rago27/XLR8/README.md

# XLR8
Contains the experiences, learnings, innovations and pictures of XLR8, by Team Osiris. Here's our bot:
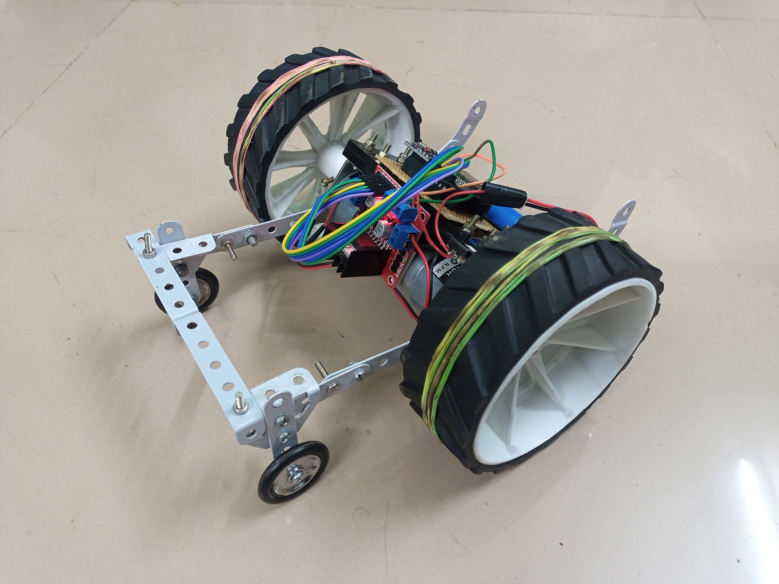
[picture p1: pics/v2_rear.jpeg]
Our Bot
