rago27/XLR8/pics/firstboard.jpg

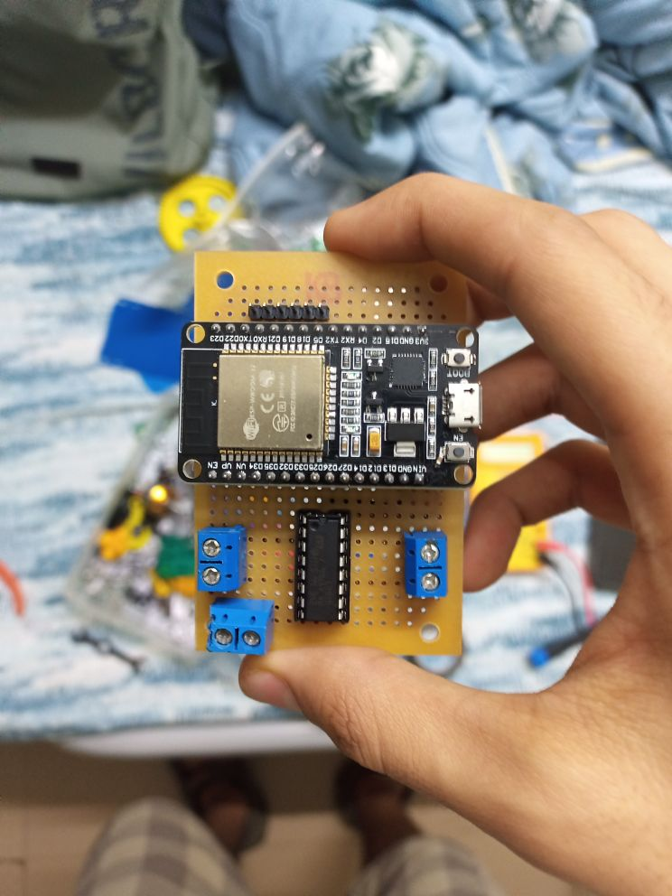
pics/firstboard.jpg
