rago27/XLR8/pics/inside_johnson.jpg

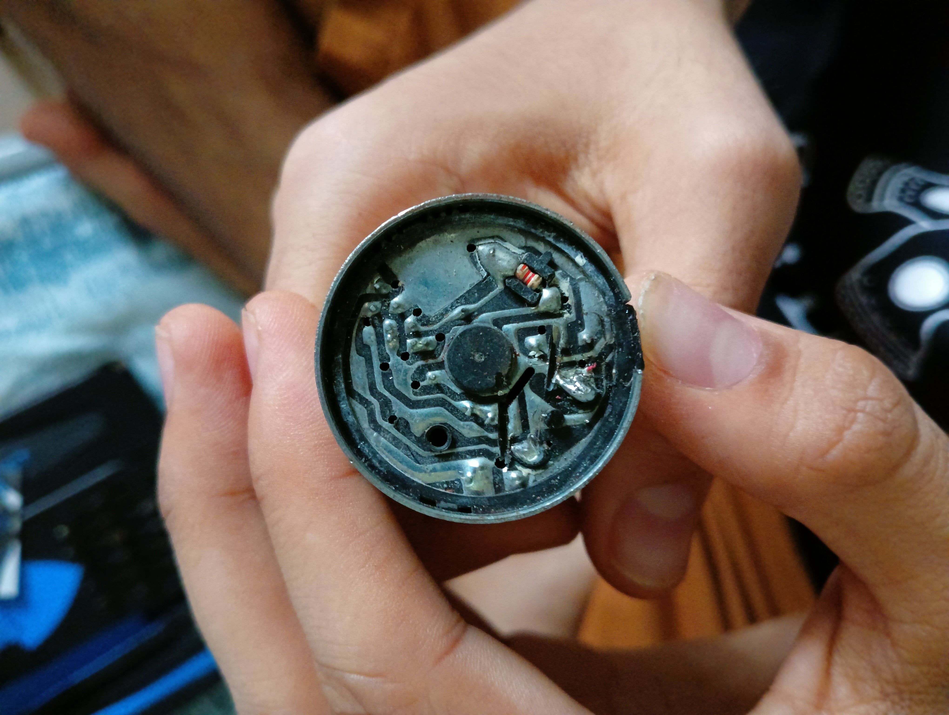
pics/inside_johnson.jpg
