rago27/XLR8/pics/v1.5_bottom.jpeg

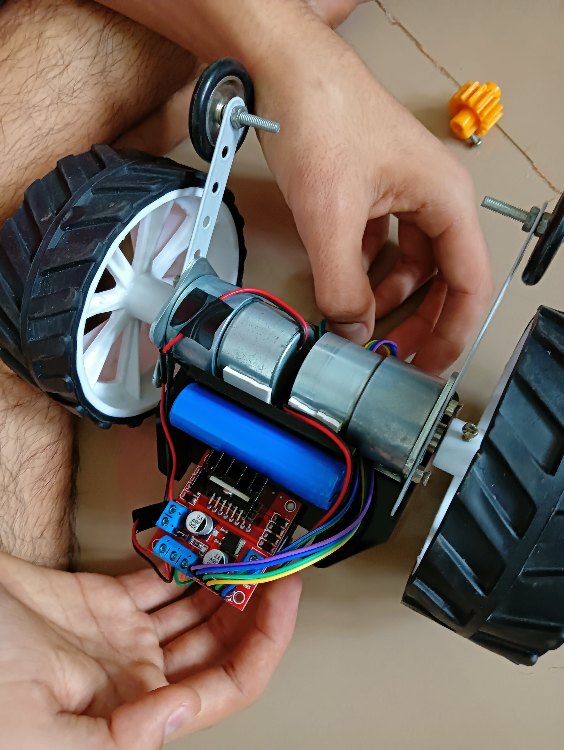
pics/v1.5_bottom.jpeg
