rago27/XLR8/pics/v1_FV.jpeg

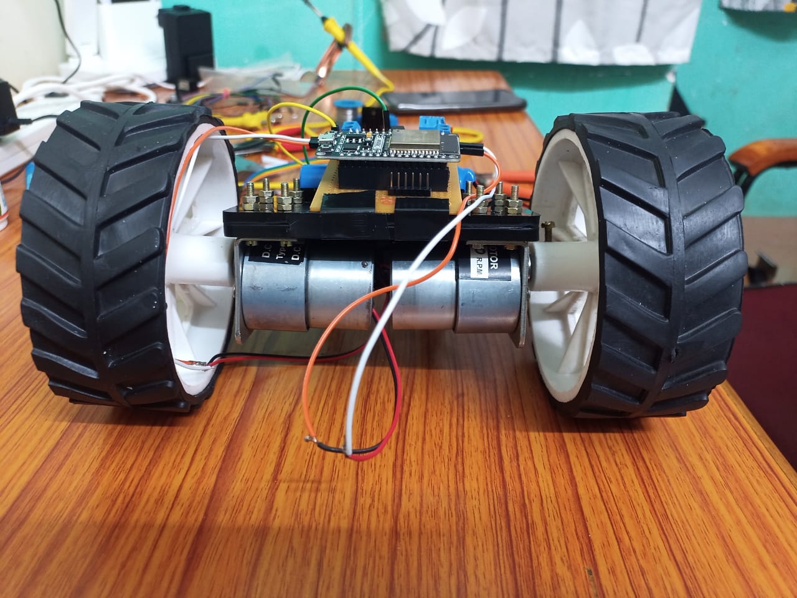
pics/v1_FV.jpeg
