rago27/XLR8/pics/v1_iso.jpeg

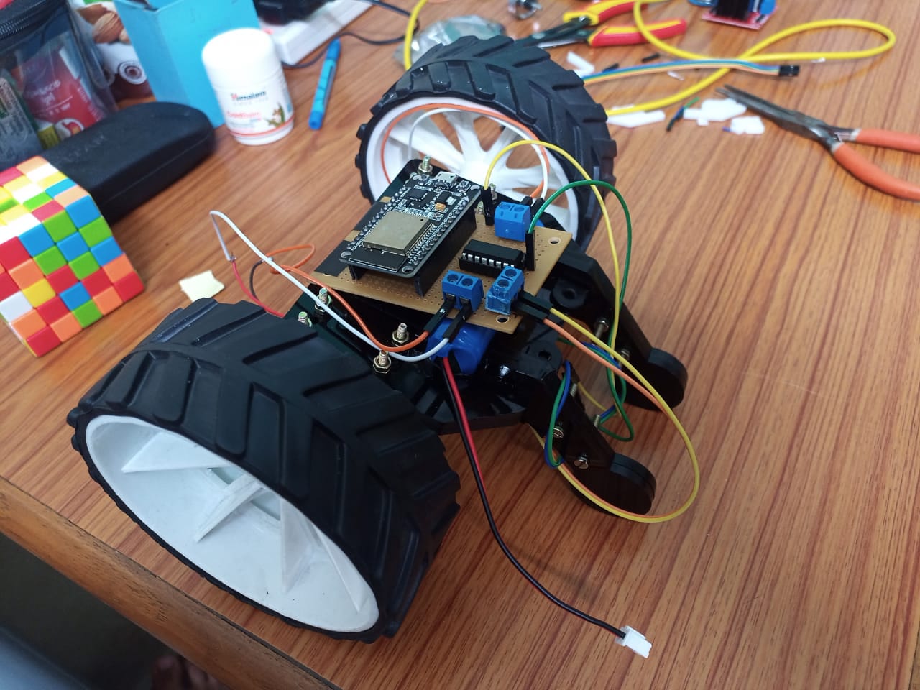
pics/v1_iso.jpeg
