rago27/XLR8/pics/v1_TV.jpeg

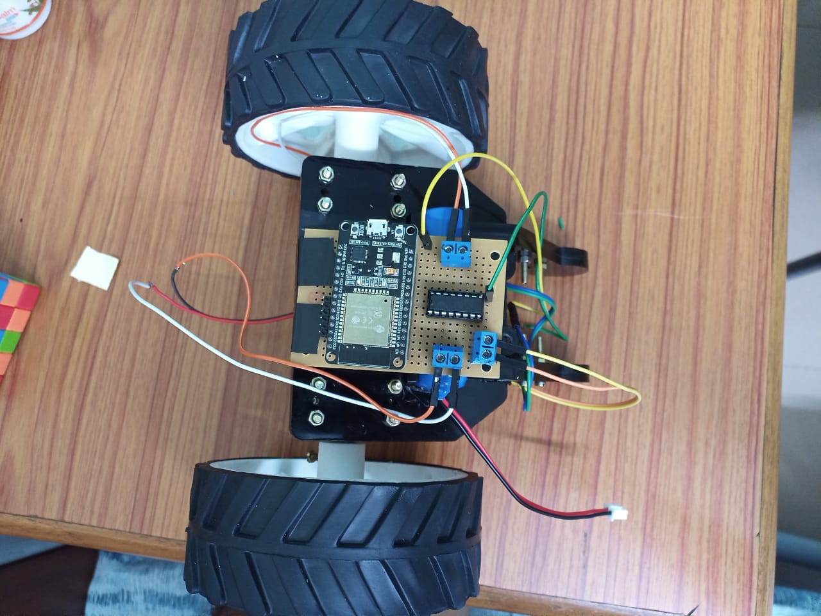
pics/v1_TV.jpeg
