rago27/XLR8/pics/v2_front.jpeg

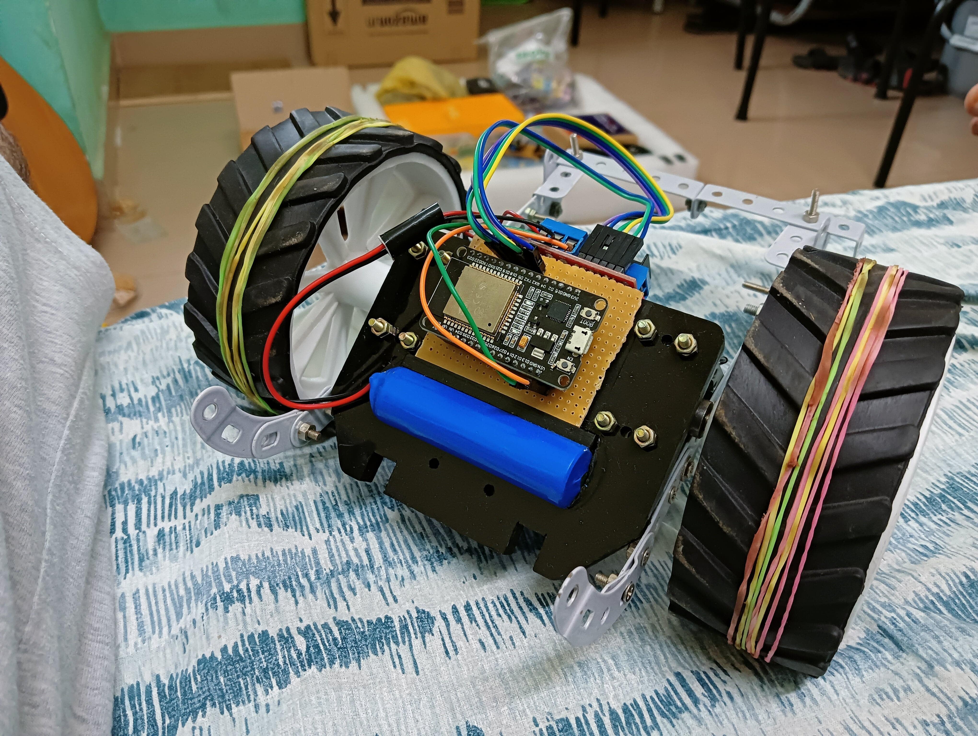
pics/v2_front.jpeg
