rago27/XLR8/pics/soldercircuit.jpg

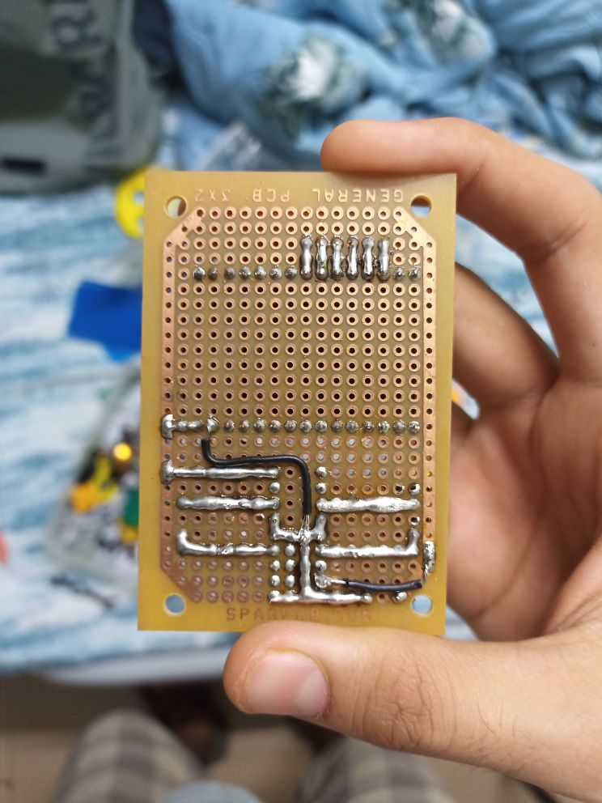
pics/soldercircuit.jpg
